n0ki20/kicad_share/3dmodels/RTC_DS3231/HW84_03.png

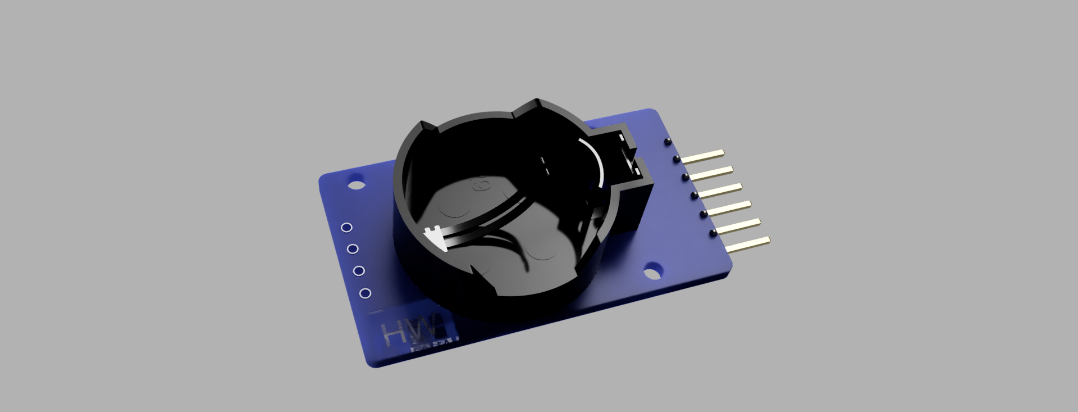
3dmodels/RTC_DS3231/HW84_03.png
