n0ki20/kicad_share/template/KN/Unbe1nannt.png

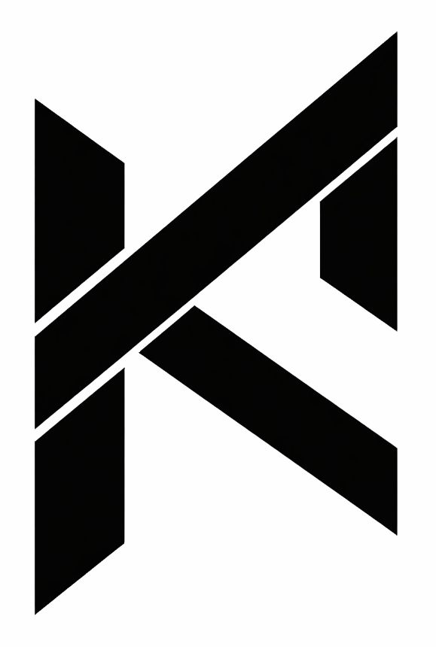
template/KN/Unbe1nannt.png
