n0ki20/kicad_share/3dmodels/ALUTRONIC_FI344SE/Aufsteckkühlkörper, TO-220, 27KW v3.step

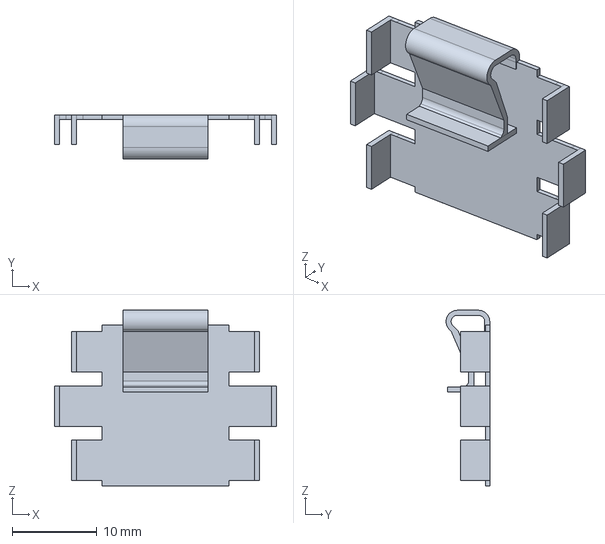
[picture p8: CAD file, 2024-12-22]
3dmodels/ALUTRONIC_FI344SE/Aufsteckkühlkörper, TO-220, 27KW v3.step
26.2 x 5.17 x 20.7 mm
