n0ki20/kicad_share/3dmodels/APEM_ILR3SAD2L0S/ilr3sad2x1242.stp

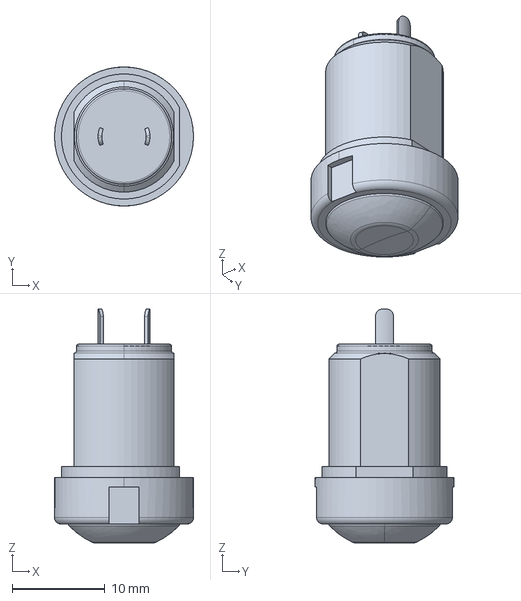
[picture p9: CAD file, 2024-12-22]
3dmodels/APEM_ILR3SAD2L0S/ilr3sad2x1242.stp
15.0 x 15.0 x 25.2 mm
