n0ki20/kicad_share/3dmodels/BOURNS_3296W/Bourns-3296W.step

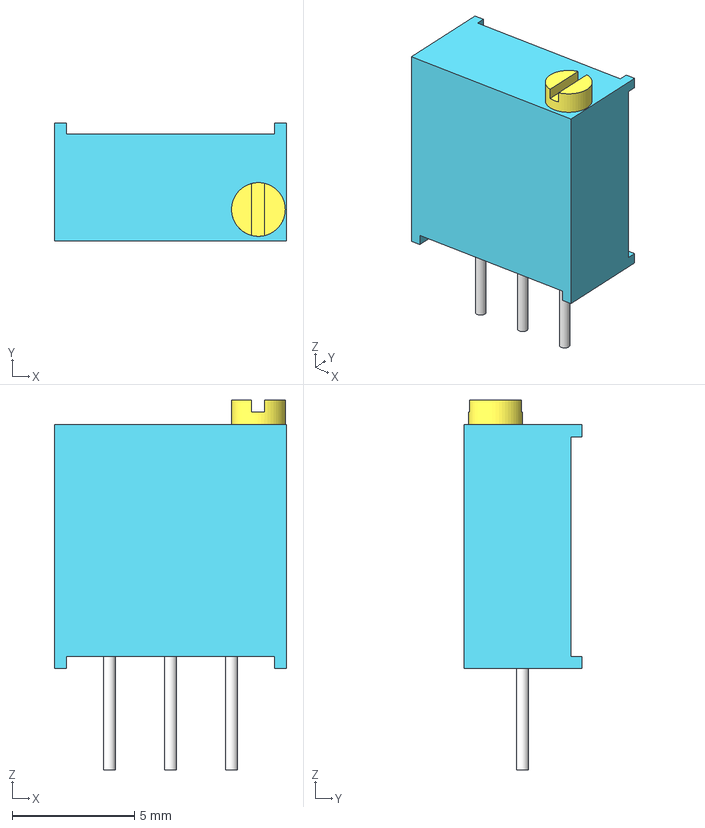
[picture p10: CAD file, 2024-12-22]
3dmodels/BOURNS_3296W/Bourns-3296W.step
9.50 x 4.85 x 15.2 mm
Screw
Pins
