n0ki20/kicad_share/3dmodels/D_SMA.step

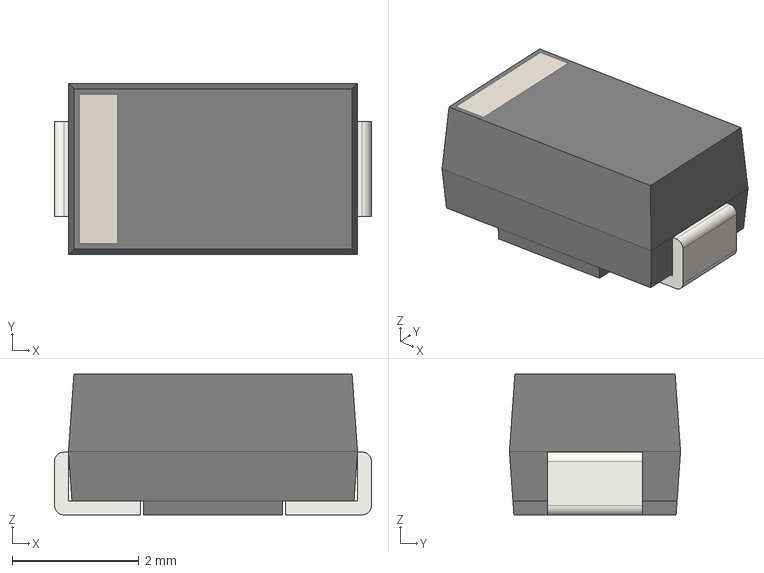
[picture p11: CAD file, 2024-12-22]
3dmodels/D_SMA.step
5.00 x 2.70 x 2.22 mm
