n0ki20/kicad_share/3dmodels/ESP32-WROOM-32E-N4/ESP32-WROOM-32E-N4.stp

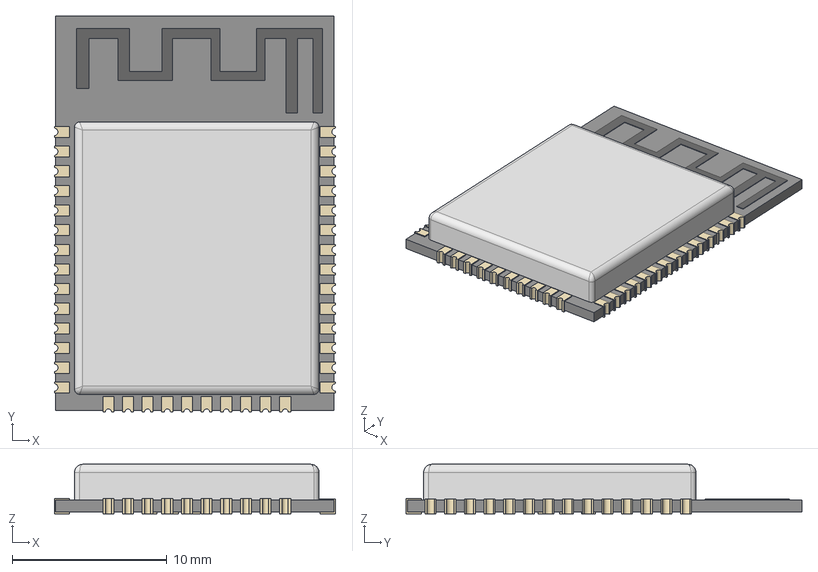
[picture p13: CAD file, 2025-10-26]
3dmodels/ESP32-WROOM-32E-N4/ESP32-WROOM-32E-N4.stp
18.2 x 25.6 x 3.20 mm
