n0ki20/kicad_share/3dmodels/ESP32S3WROOM1N16R8/ESP32-S3-WROOM-1-N16R8.stp

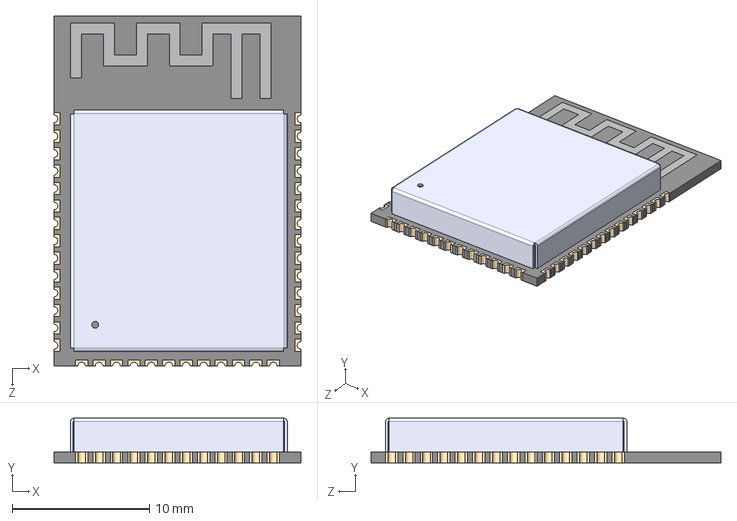
[picture p14: CAD file, 2025-10-26]
3dmodels/ESP32S3WROOM1N16R8/ESP32-S3-WROOM-1-N16R8.stp
18.0 x 3.25 x 25.5 mm
