n0ki20/kicad_share/3dmodels/EVERL_12-23CR6GHBHC-A012C/12-23C_R6GHBHC-A01_2C.stp

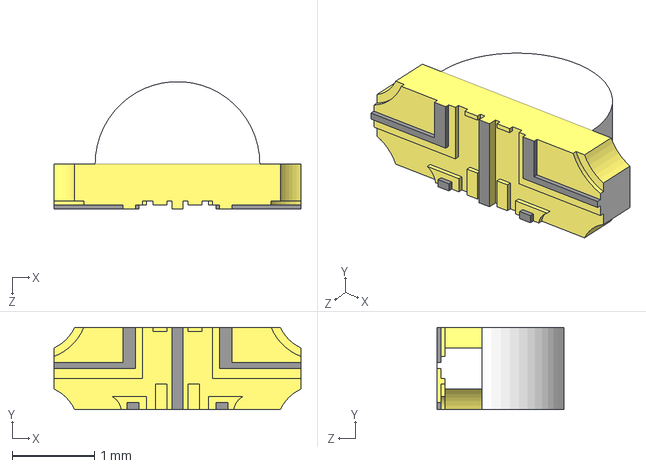
[picture p15: CAD file, 2024-12-22]
3dmodels/EVERL_12-23CR6GHBHC-A012C/12-23C_R6GHBHC-A01_2C.stp
3.00 x 1.00 x 1.55 mm
