n0ki20/kicad_share/3dmodels/FASTR_1008F-220K-08/AISC-1008F-4R7G-T--3DModel-STEP-400430.STEP

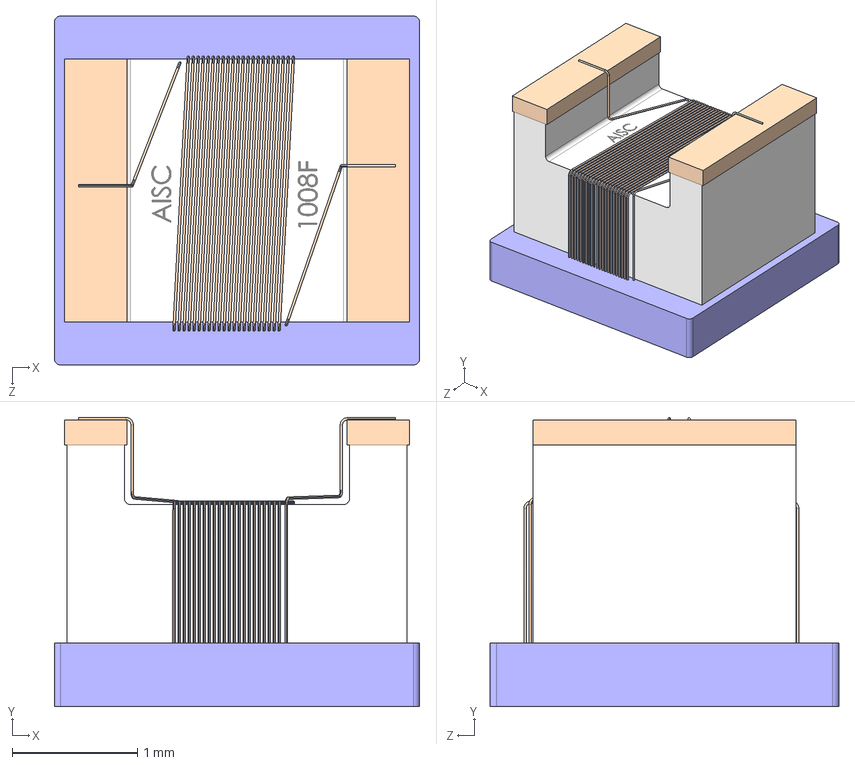
[picture p16: CAD file, 2025-01-09]
3dmodels/FASTR_1008F-220K-08/AISC-1008F-4R7G-T--3DModel-STEP-400430.STEP
2.92 x 2.31 x 2.79 mm
