n0ki20/kicad_share/3dmodels/FASTRON_PISR/PISR-101M-04.stp

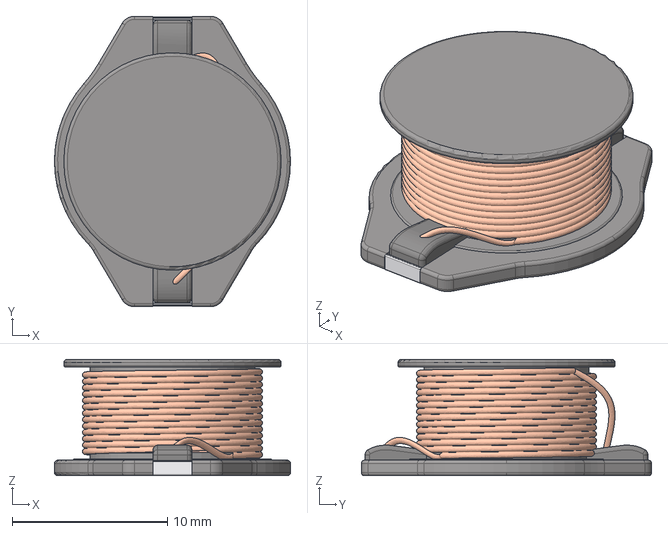
[picture p17: CAD file, 2026-04-06]
3dmodels/FASTRON_PISR/PISR-101M-04.stp
15.2 x 18.7 x 7.50 mm
