n0ki20/kicad_share/3dmodels/FIN_45.31.7.012.0310/4531.stp

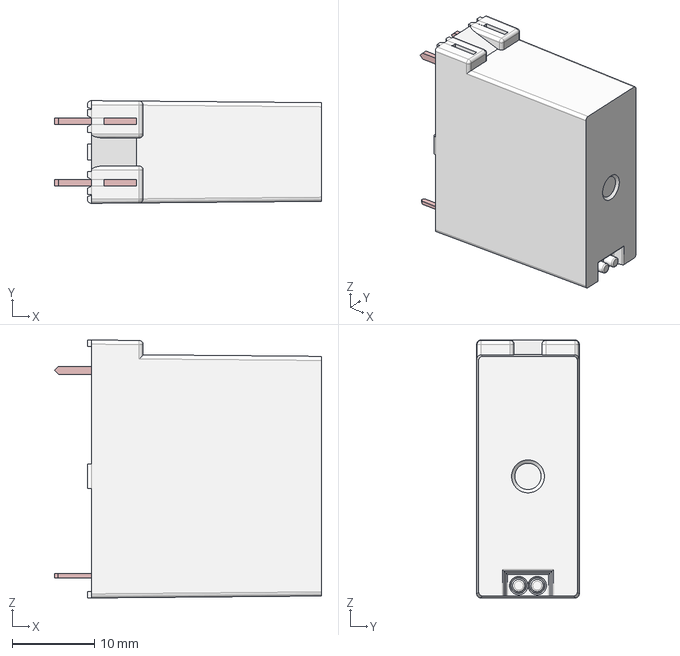
[picture p18: CAD file, 2024-12-22]
3dmodels/FIN_45.31.7.012.0310/4531.stp
32.5 x 12.5 x 31.4 mm
