n0ki20/kicad_share/3dmodels/FISCH_FK 242 SA 220 O/fk_242_sa_220_o.stp

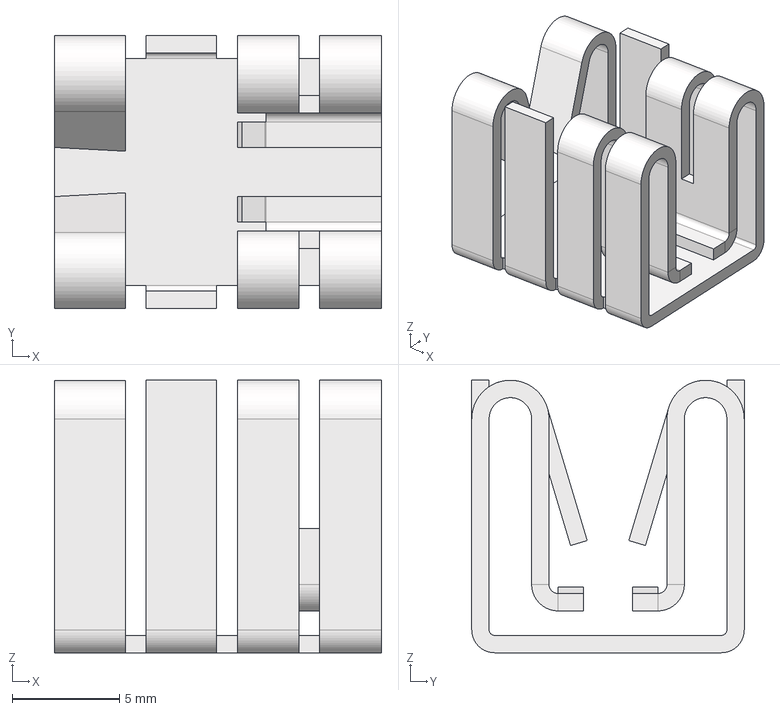
[picture p19: CAD file, 2024-12-22]
3dmodels/FISCH_FK 242 SA 220 O/fk_242_sa_220_o.stp
15.2 x 12.7 x 12.7 mm
