n0ki20/kicad_share/3dmodels/FISCH_FK 244 13 D PAK/fk_244_13_d_pak.stp

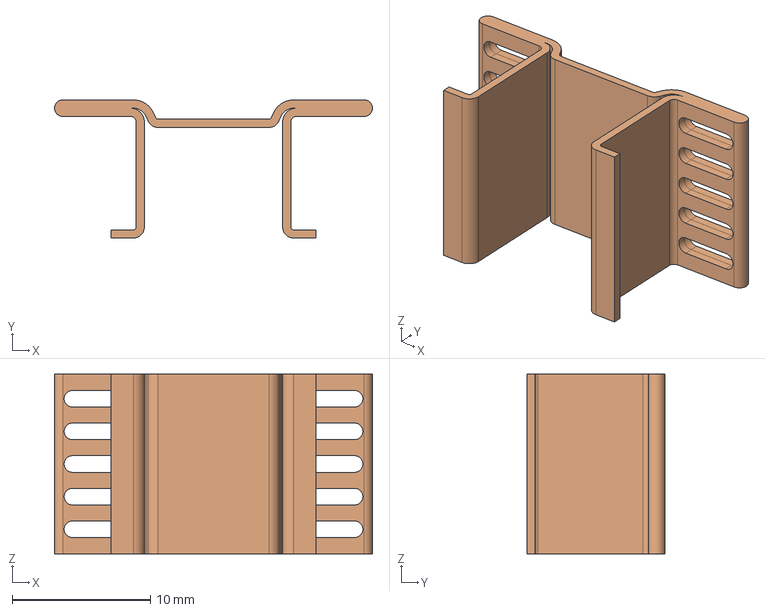
[picture p20: CAD file, 2024-12-22]
3dmodels/FISCH_FK 244 13 D PAK/fk_244_13_d_pak.stp
23.0 x 10.0 x 13.0 mm
