n0ki20/kicad_share/3dmodels/FREESC_MPX2200/User Library-MPX5100GP-2.step

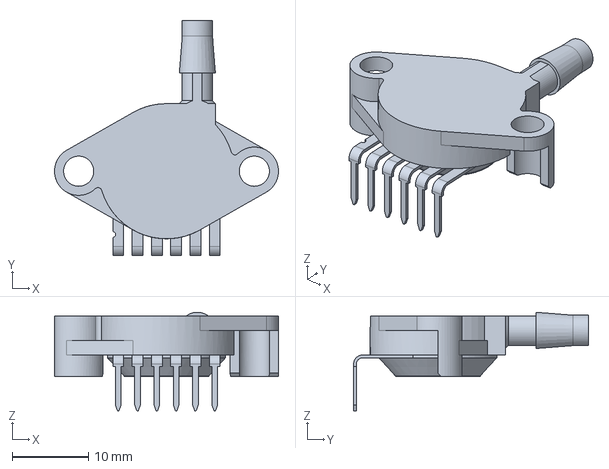
[picture p21: CAD file, 2024-12-22]
3dmodels/FREESC_MPX2200/User Library-MPX5100GP-2.step
29.5 x 30.9 x 13.0 mm
