n0ki20/kicad_share/3dmodels/GCT_BC034-04-A-V-0150-L-D/BC034-04-A-V-0150-L-D--3DModel-STEP-56544.STEP

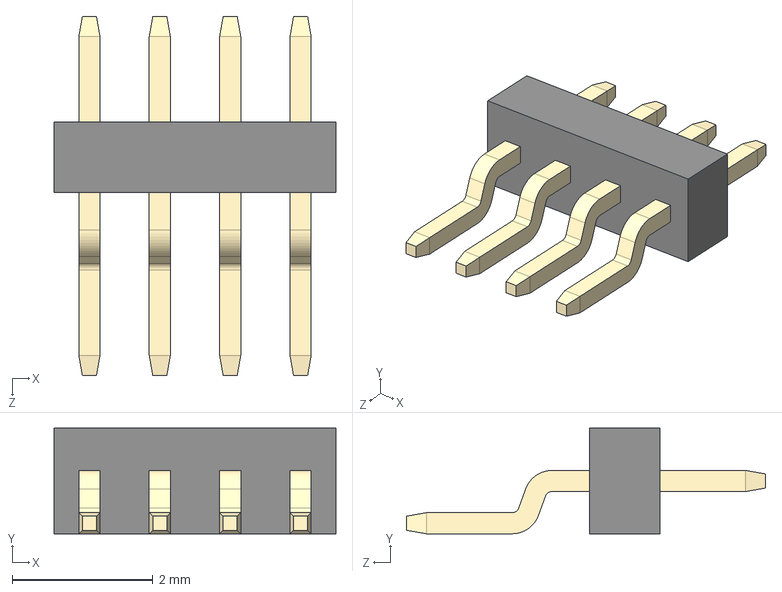
[picture p22: CAD file, 2026-10-28]
3dmodels/GCT_BC034-04-A-V-0150-L-D/BC034-04-A-V-0150-L-D--3DModel-STEP-56544.STEP
4.00 x 1.50 x 5.10 mm
body^BC034-xxxxx
pin^BC034-xxxxx x 4
