n0ki20/kicad_share/3dmodels/GENICOM_GUVA-S12SD/CR_GUVA-S12SD_GCM.step

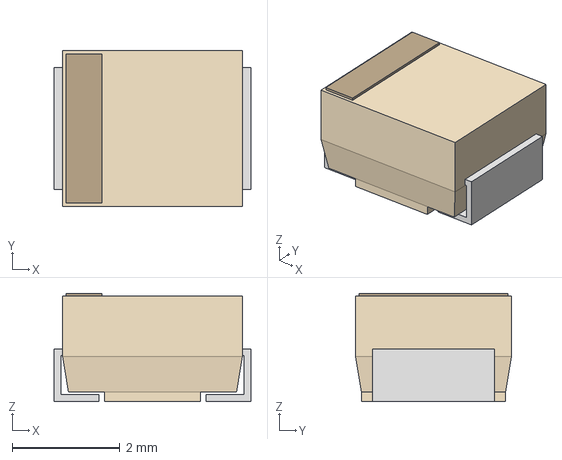
[picture p23: CAD file, 2026-08-25]
3dmodels/GENICOM_GUVA-S12SD/CR_GUVA-S12SD_GCM.step
3.66 x 2.90 x 2.01 mm
