n0ki20/kicad_share/3dmodels/I2C-OLED-Display_128x32/128x32-OLED.STEP

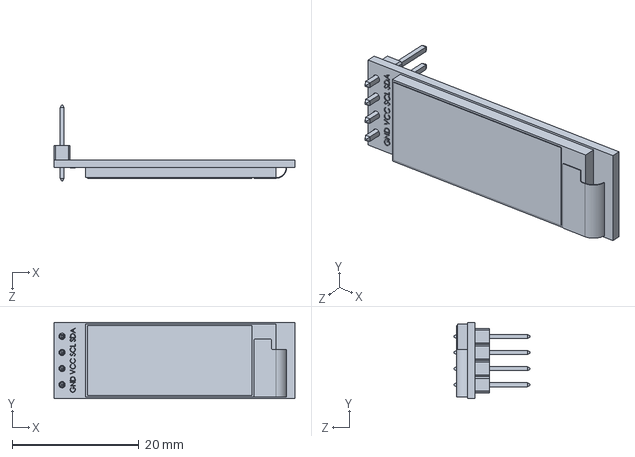
[picture p24: CAD file, 2024-12-22]
3dmodels/I2C-OLED-Display_128x32/128x32-OLED.STEP
38.0 x 12.0 x 11.9 mm
