n0ki20/kicad_share/3dmodels/I2C-OLED-Display_128x64/0,96-Zoll_OLED_IIC.stp

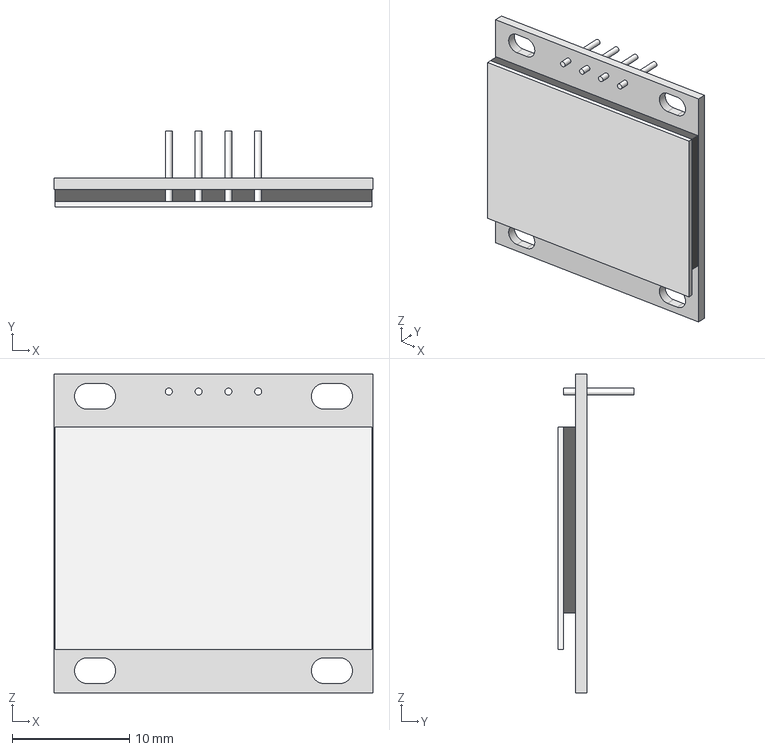
[picture p25: CAD file, 2024-12-22]
3dmodels/I2C-OLED-Display_128x64/0,96-Zoll_OLED_IIC.stp
27.2 x 6.50 x 27.2 mm
