n0ki20/kicad_share/3dmodels/I2C-OLED-Display_128x64_1.3/HiLetgo - DM-OLED13-625.stp

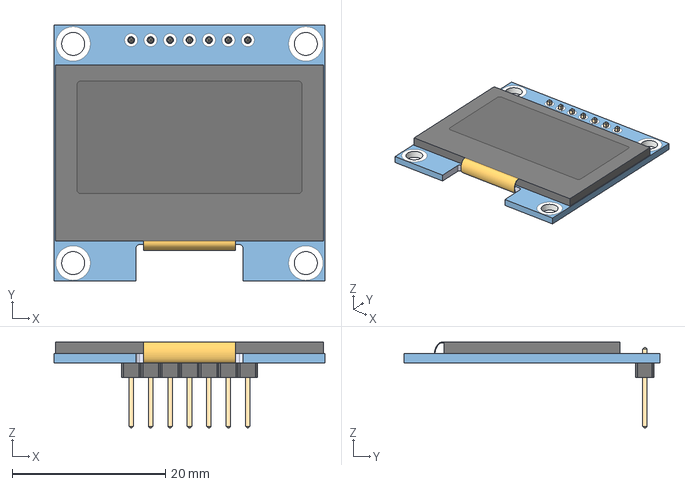
[picture p26: CAD file, 2024-12-22]
3dmodels/I2C-OLED-Display_128x64_1.3/HiLetgo - DM-OLED13-625.stp
35.4 x 33.5 x 11.2 mm
