n0ki20/kicad_share/3dmodels/JOY_ESP-12F/esp-12f.stp

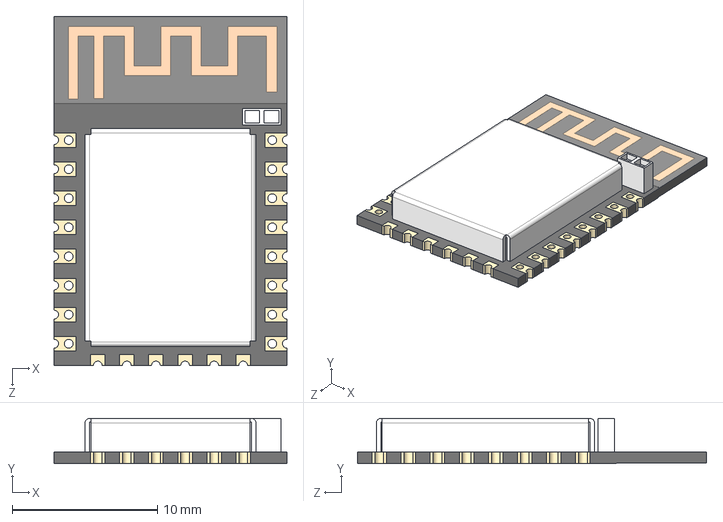
[picture p27: CAD file, 2024-12-22]
3dmodels/JOY_ESP-12F/esp-12f.stp
16.0 x 3.10 x 24.0 mm
