n0ki20/kicad_share/3dmodels/JST_B2P-SHF-1AA(LF)(SN)/JST_-_B2P-SHF-1AA-LFSN.step

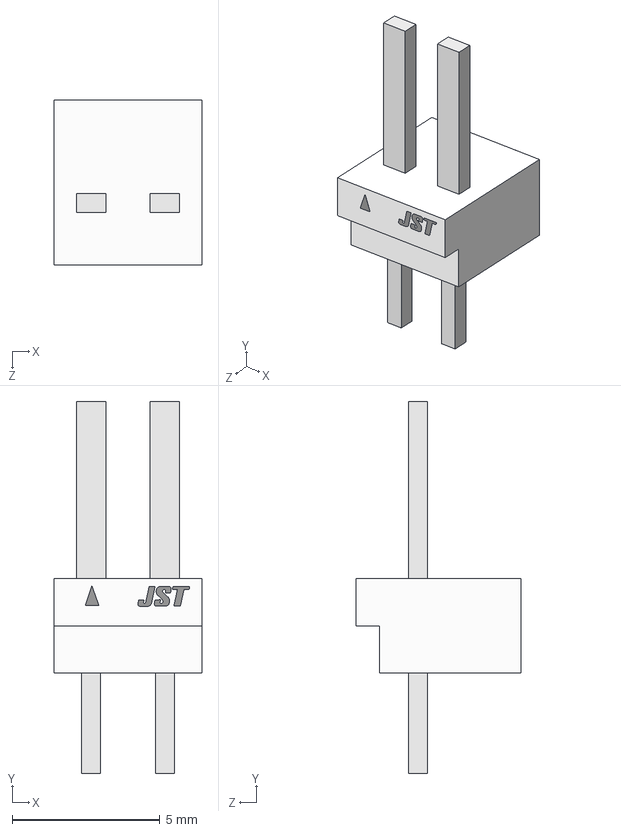
[picture p28: CAD file, 2024-12-22]
3dmodels/JST_B2P-SHF-1AA(LF)(SN)/JST_-_B2P-SHF-1AA-LFSN.step
5.00 x 12.6 x 5.60 mm
Pins
New Marking
JST Logo
