n0ki20/kicad_share/3dmodels/KEY_1012/BatteryHolder_Keystone_1012_2xAA.step

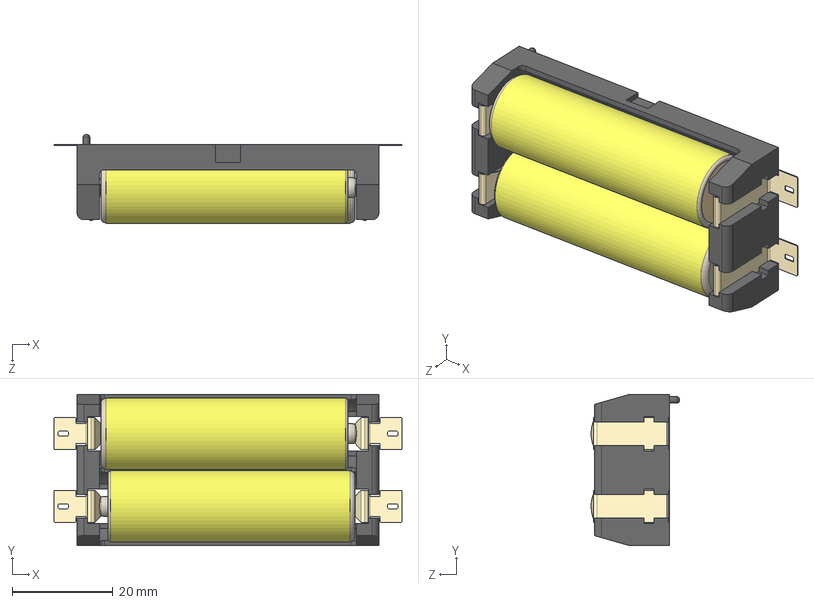
[picture p29: CAD file, 2024-12-22]
3dmodels/KEY_1012/BatteryHolder_Keystone_1012_2xAA.step
69.0 x 30.0 x 17.6 mm
AAx2 SMT 422 Battery Holder
connector x 4
AA Battery_new x 2
bung_battery x 2
grafite_electrode x 2
cap x 2
