n0ki20/kicad_share/3dmodels/KEY_1013/keystone-PN1013.STEP

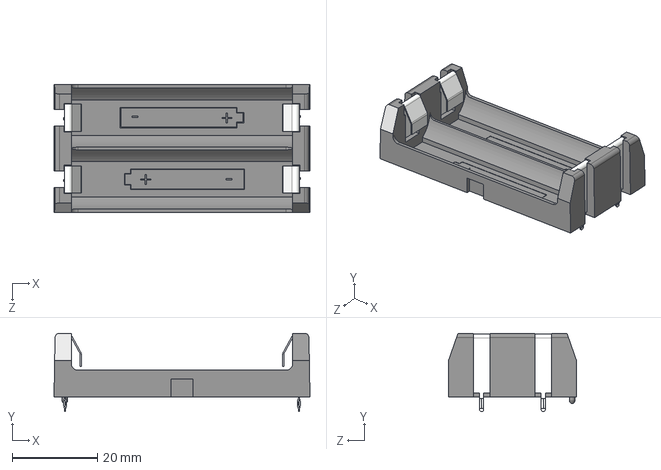
[picture p30: CAD file, 2024-12-22]
3dmodels/KEY_1013/keystone-PN1013.STEP
59.9 x 18.3 x 30.0 mm
