n0ki20/kicad_share/3dmodels/KEY_1022/1022.step

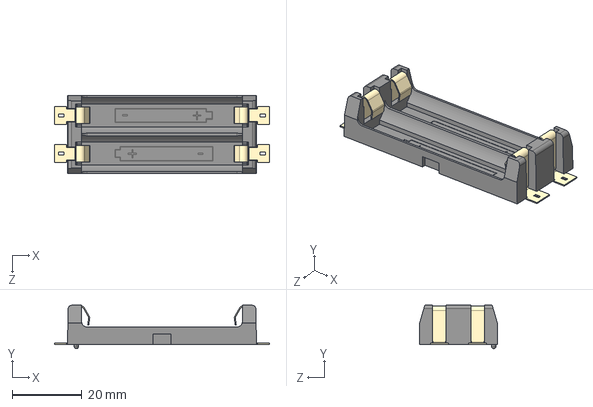
[picture p31: CAD file, 2024-12-22]
3dmodels/KEY_1022/1022.step
61.5 x 12.4 x 22.2 mm
