n0ki20/kicad_share/3dmodels/KEY_1023/1023.step

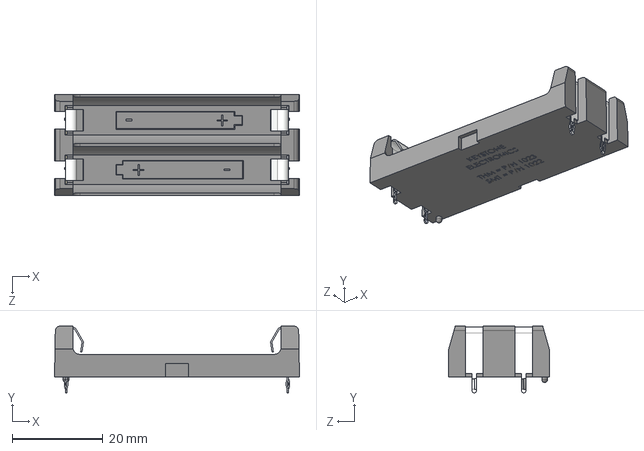
[picture p32: CAD file, 2025-04-23]
3dmodels/KEY_1023/1023.step
54.1 x 14.7 x 22.2 mm
