n0ki20/kicad_share/3dmodels/KEY_KEYS7693/7693--3DModel-STEP-630548.STEP

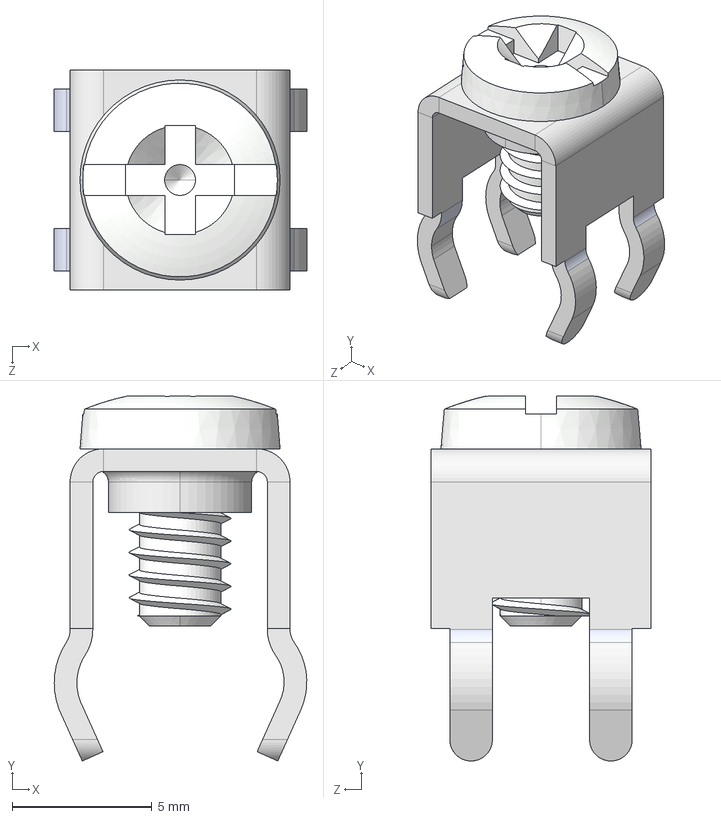
[picture p33: CAD file, 2024-12-22]
3dmodels/KEY_KEYS7693/7693--3DModel-STEP-630548.STEP
9.04 x 13.1 x 7.87 mm
