n0ki20/kicad_share/3dmodels/LTPL-G35UV275GR-E/LTPL-G35UV275GR-E.stp

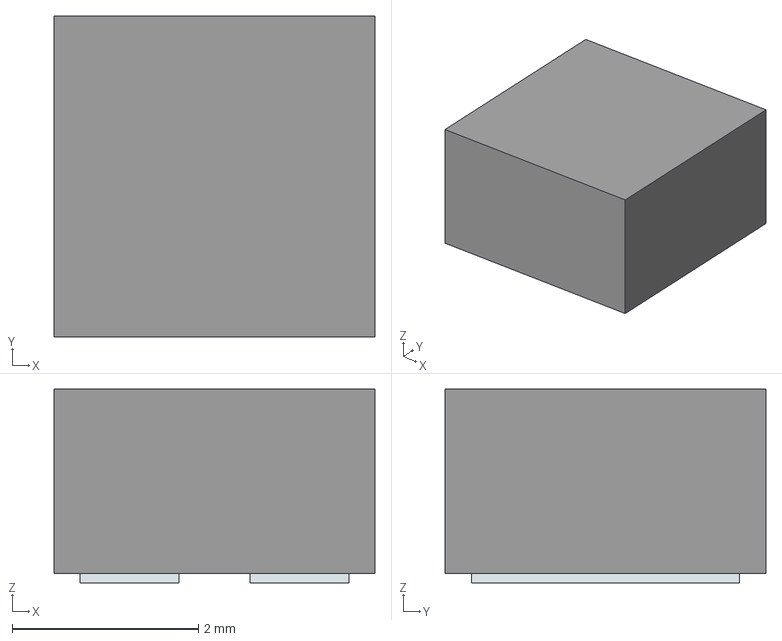
[picture p34: CAD file, 2026-04-06]
3dmodels/LTPL-G35UV275GR-E/LTPL-G35UV275GR-E.stp
3.45 x 3.45 x 2.08 mm
Pins
