n0ki20/kicad_share/3dmodels/LUCKY_C3535DUVCQBQ5D/LUCKY_C3535DUVCQBQ5D.stp

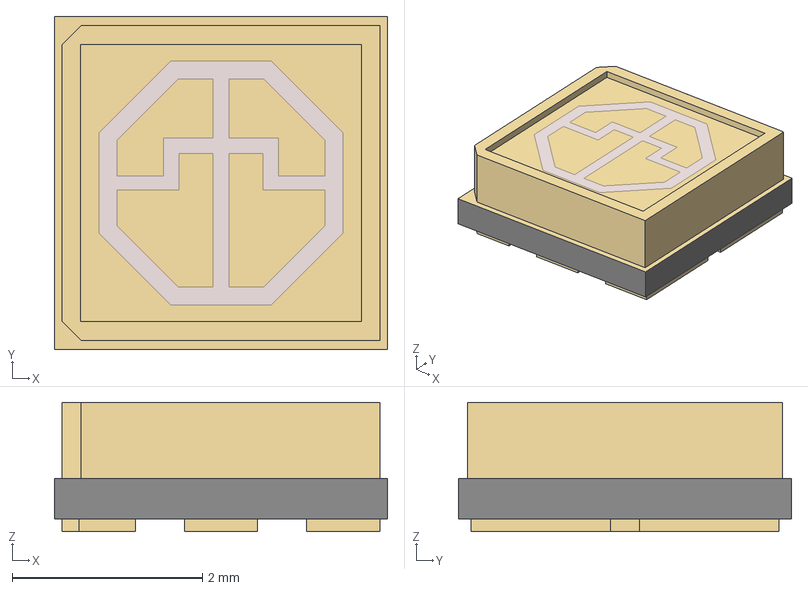
[picture p35: CAD file, 2026-10-28]
3dmodels/LUCKY_C3535DUVCQBQ5D/LUCKY_C3535DUVCQBQ5D.stp
3.50 x 3.50 x 1.36 mm
