n0ki20/kicad_share/3dmodels/METZ_SR99S01VBNN01/SR99.stp

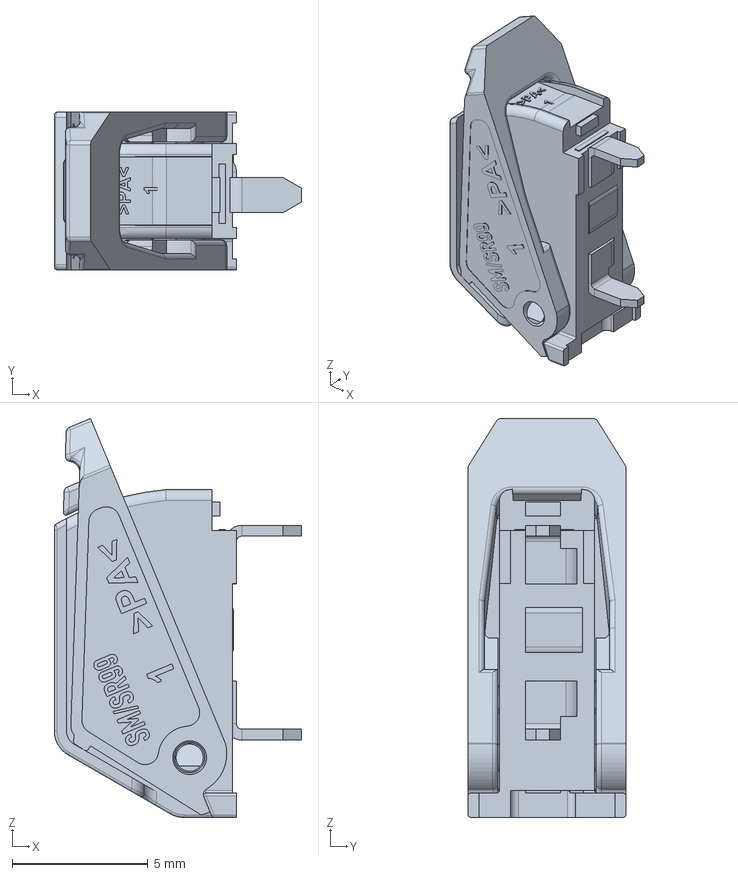
[picture p36: CAD file, 2024-12-22]
3dmodels/METZ_SR99S01VBNN01/SR99.stp
9.10 x 5.80 x 14.7 mm
