n0ki20/kicad_share/3dmodels/OSRAM_AS7331-AQF/AS7331-AQFT.stp

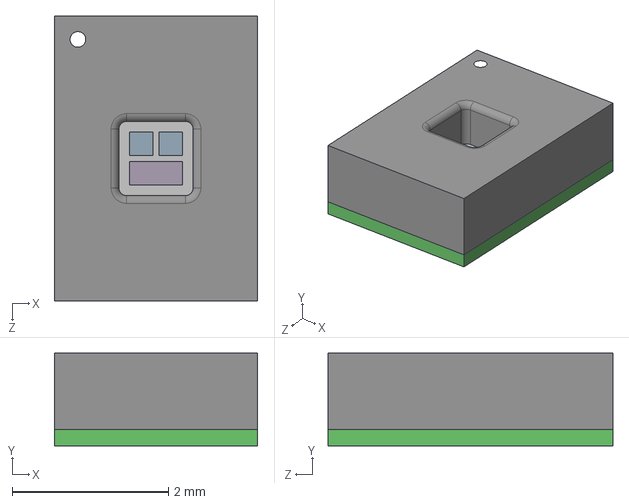
[picture p37: CAD file, 2026-08-25]
3dmodels/OSRAM_AS7331-AQF/AS7331-AQFT.stp
2.60 x 1.19 x 3.65 mm
