n0ki20/kicad_share/3dmodels/R_0508/R_0508.stp

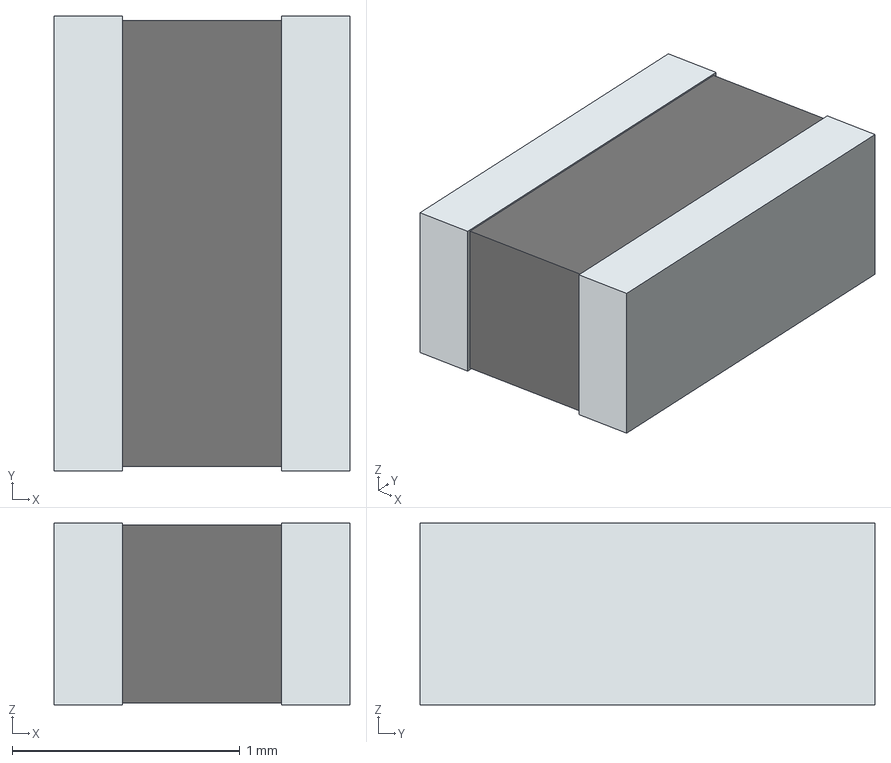
[picture p38: CAD file, 2026-10-28]
3dmodels/R_0508/R_0508.stp
1.30 x 2.00 x 0.8 mm
term1
term2
