n0ki20/kicad_share/3dmodels/RTC_DS1307_DS1302/REAL_TIME_SHEELD.stp

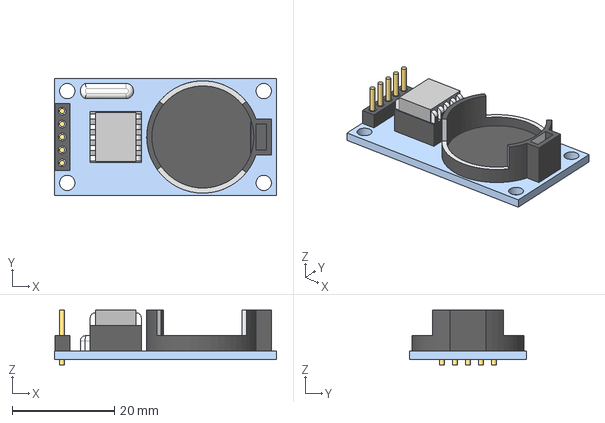
[picture p39: CAD file, 2024-12-22]
3dmodels/RTC_DS1307_DS1302/REAL_TIME_SHEELD.stp
43.5 x 23.0 x 10.7 mm
