n0ki20/kicad_share/3dmodels/RTC_DS3231/HW-84 v7.step

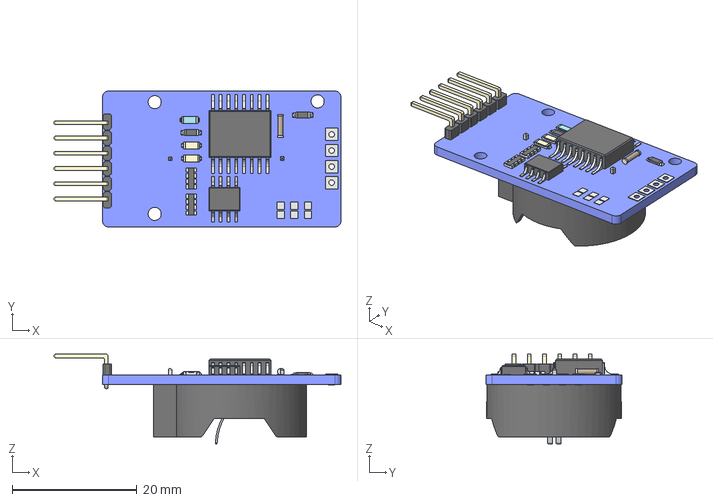
[picture p40: CAD file, 2024-12-22]
3dmodels/RTC_DS3231/HW-84 v7.step
46.1 x 21.9 x 14.4 mm
