n0ki20/kicad_share/3dmodels/SW_ALPS_402097/EC11-THT-25K-black.step

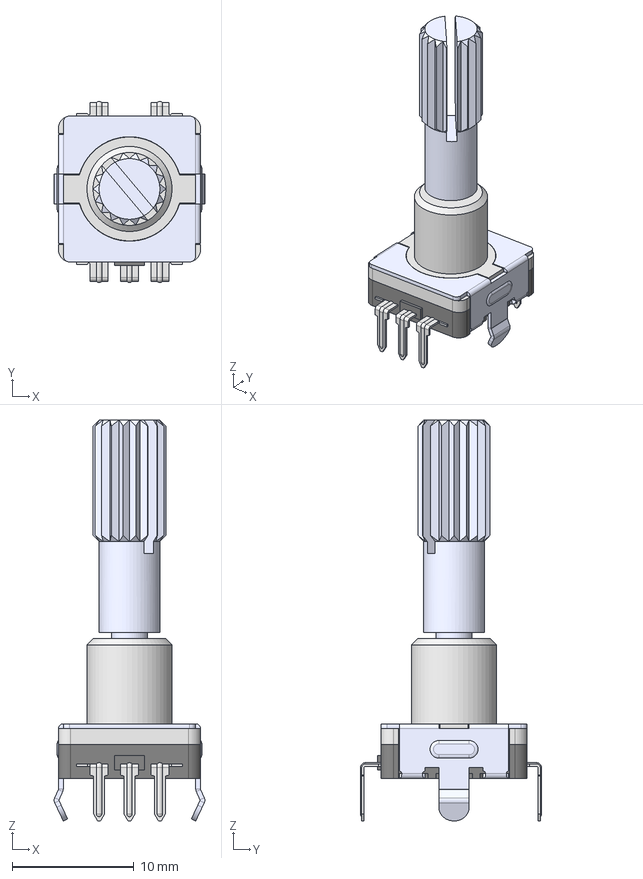
[picture p41: CAD file, 2024-12-22]
3dmodels/SW_ALPS_402097/EC11-THT-25K-black.step
12.4 x 14.9 x 33.0 mm
Lb7
25K
EC11-Housing-THT
