n0ki20/kicad_share/3dmodels/TRACO_TSR 0.5SM/TSR_0.5-2450SM.stp

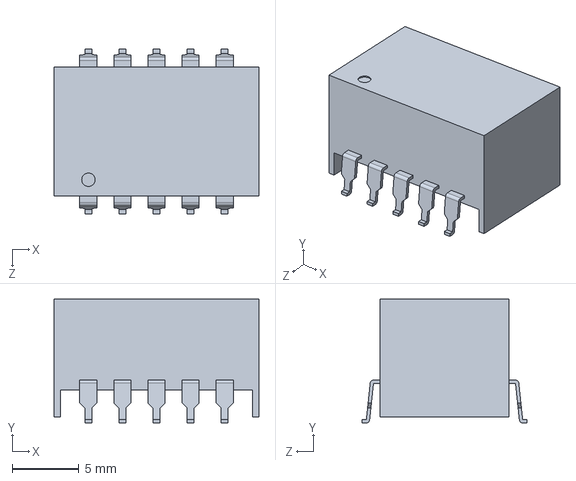
[picture p42: CAD file, 2024-12-22]
3dmodels/TRACO_TSR 0.5SM/TSR_0.5-2450SM.stp
15.3 x 9.24 x 12.4 mm
