n0ki20/kicad_share/3dmodels/VIS_VLMU35CR40-275-120/VIS_VLMU35CR40-275-120.stp

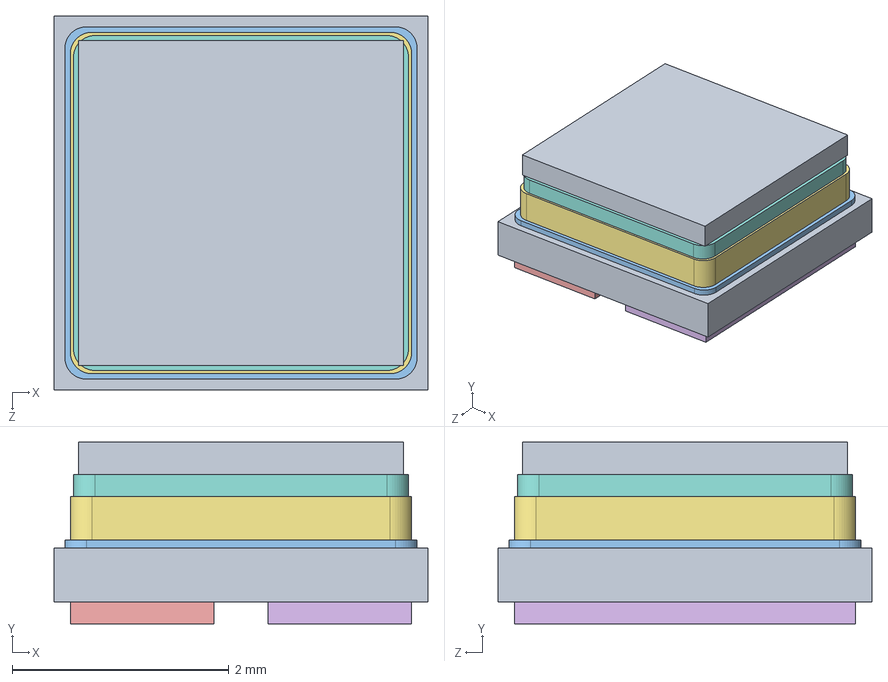
[picture p43: CAD file, 2026-10-28]
3dmodels/VIS_VLMU35CR40-275-120/VIS_VLMU35CR40-275-120.stp
3.45 x 1.68 x 3.45 mm
G35UVC280SL SUB
G35UVC280SL CHIP PAD
G35UVC280SL SOLDER PAD
G35UVC280SL CAVITY
G35UVC280SL DAM
G35UVC280SL GLASS
G35UVCGP_chip
