n0ki20/kicad_share/3dmodels/WAGO_2059-303998-403/WAGO_2059-303998-403.stp

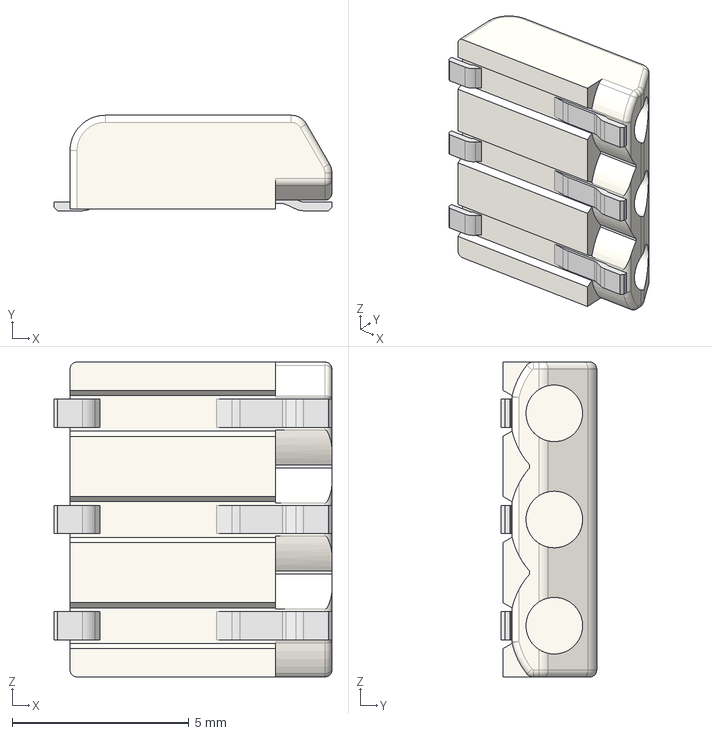
[picture p44: CAD file, 2026-04-29]
3dmodels/WAGO_2059-303998-403/WAGO_2059-303998-403.stp
7.85 x 2.70 x 8.90 mm
