n0ki20/kicad_share/3dmodels/WAGO_233-502/233-502.stp

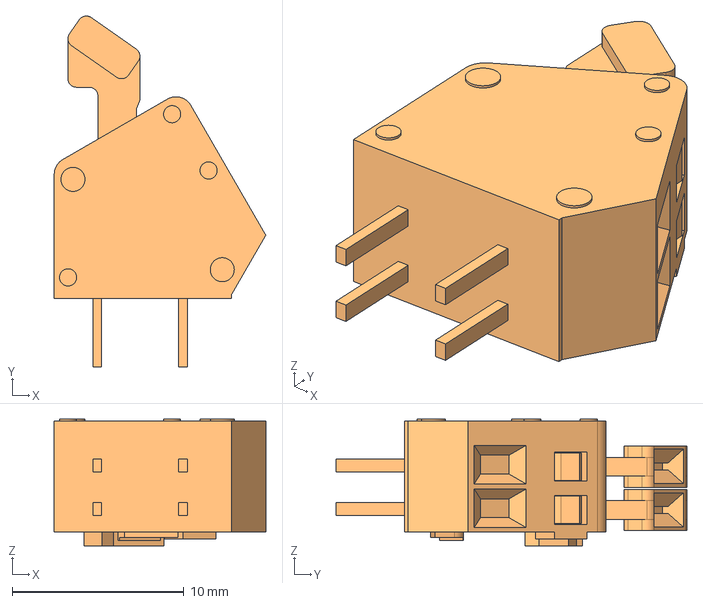
[picture p45: CAD file, 2024-12-22]
3dmodels/WAGO_233-502/233-502.stp
12.3 x 20.4 x 7.38 mm
