n0ki20/kicad_share/3dmodels/WAGO_233-503/233-503.stp

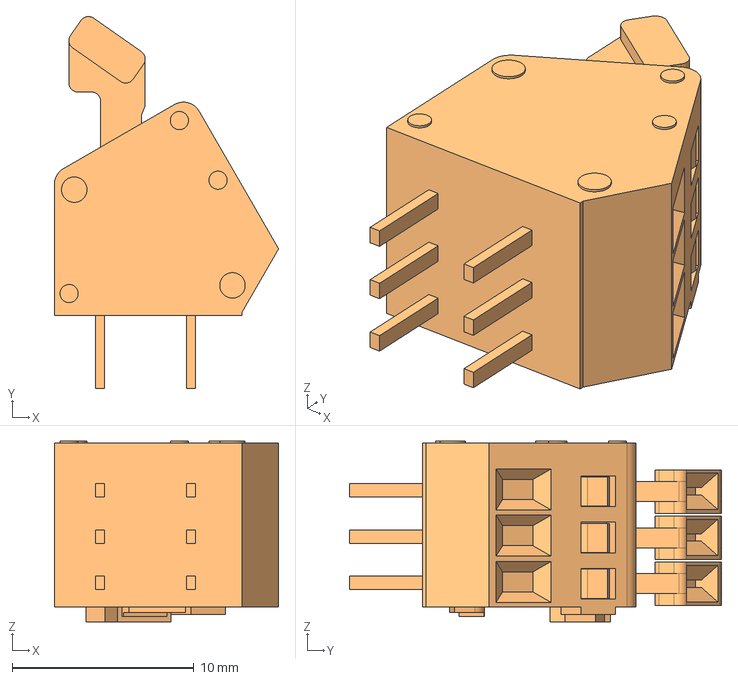
[picture p46: CAD file, 2024-12-22]
3dmodels/WAGO_233-503/233-503.stp
12.3 x 20.4 x 9.92 mm
