n0ki20/kicad_share/3dmodels/WAGO_233-504/233-504.stp

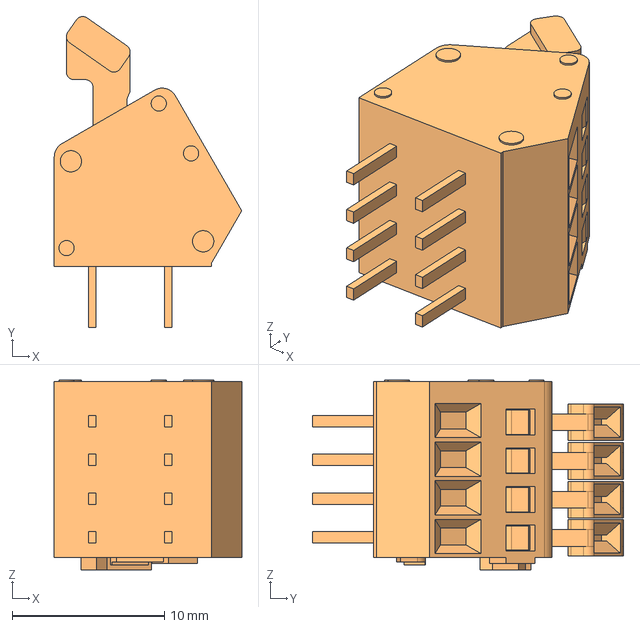
[picture p47: CAD file, 2024-12-22]
3dmodels/WAGO_233-504/233-504.stp
12.3 x 20.4 x 12.5 mm
