n0ki20/kicad_share/3dmodels/WAGO_233-505/233-505.stp

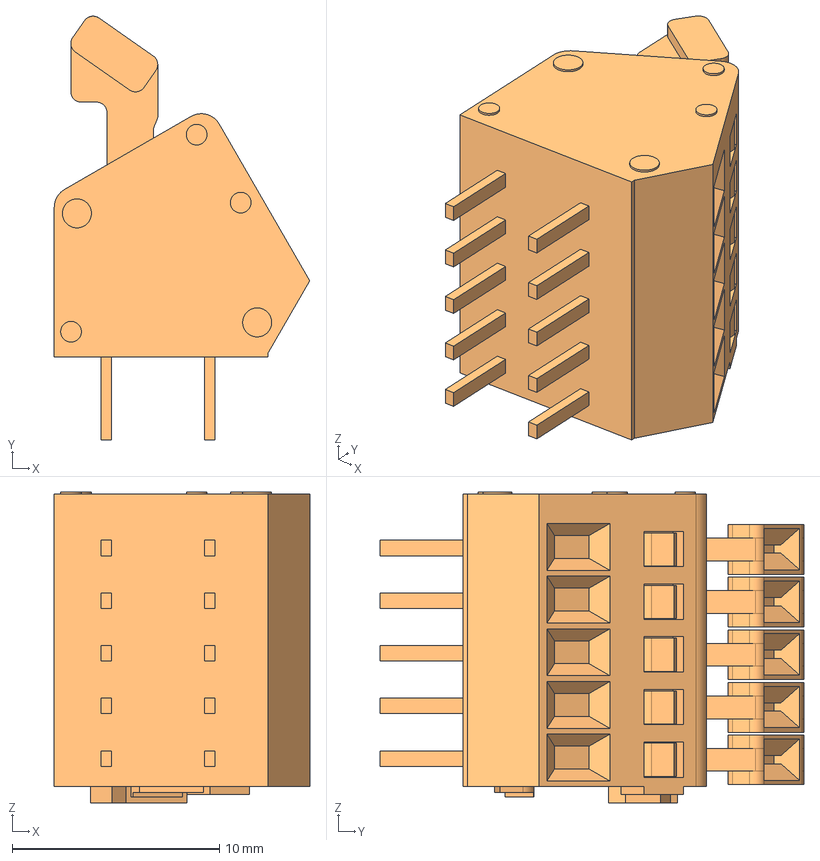
[picture p48: CAD file, 2024-12-22]
3dmodels/WAGO_233-505/233-505.stp
12.3 x 20.4 x 15.0 mm
