n0ki20/kicad_share/3dmodels/WAGO_2604-1102/2604-1102.stp

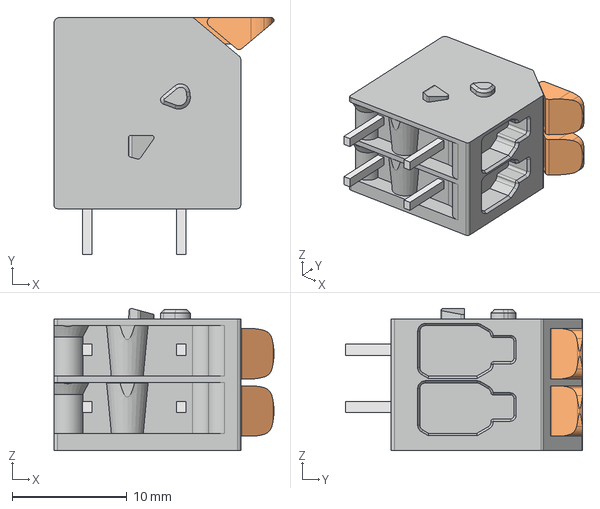
[picture p49: CAD file, 2024-12-22]
3dmodels/WAGO_2604-1102/2604-1102.stp
19.2 x 20.7 x 12.4 mm
