n0ki20/kicad_share/3dmodels/WAGO_2604-1106/M_2604-1106_WAGO.stp

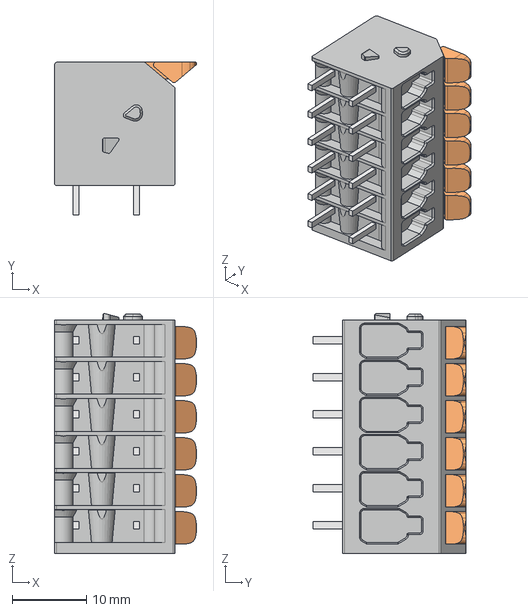
[picture p50: CAD file, 2024-12-22]
3dmodels/WAGO_2604-1106/M_2604-1106_WAGO.stp
19.2 x 20.7 x 32.4 mm
