n0ki20/kicad_share/3dmodels/WE_150066SV74000/WE_150066SV74000.stp

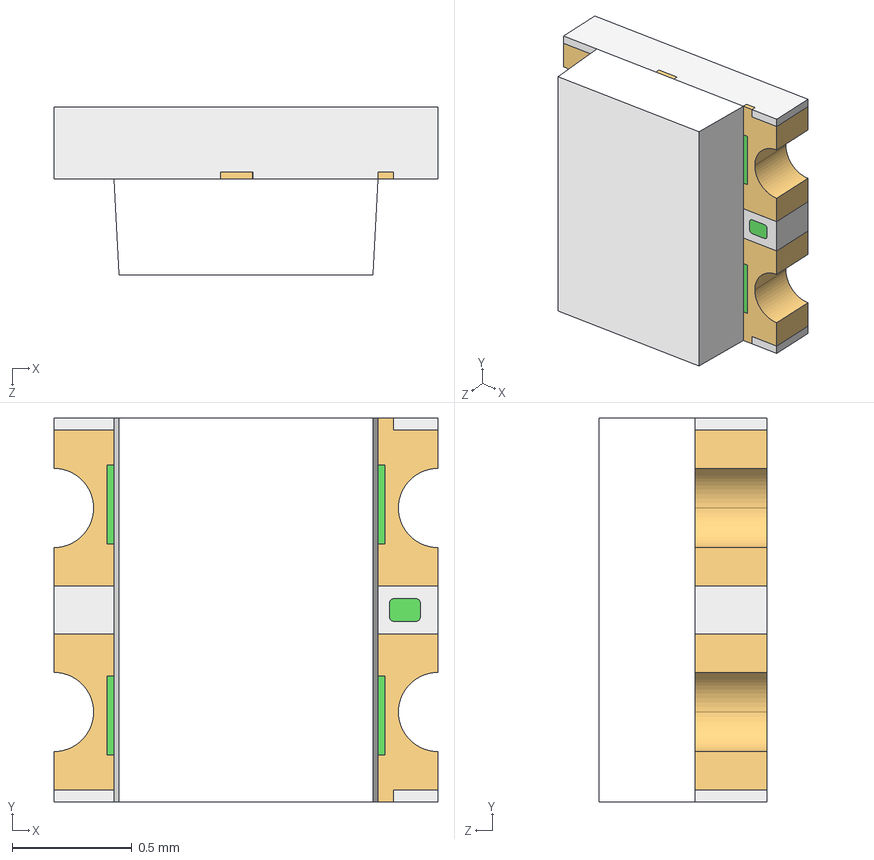
[picture p51: CAD file, 2025-01-17]
3dmodels/WE_150066SV74000/WE_150066SV74000.stp
1.60 x 1.60 x 0.7 mm
pole
contact
lense
