n0ki20/kicad_share/3dmodels/X/PinHeader_1x15_2.54_90_THT.step

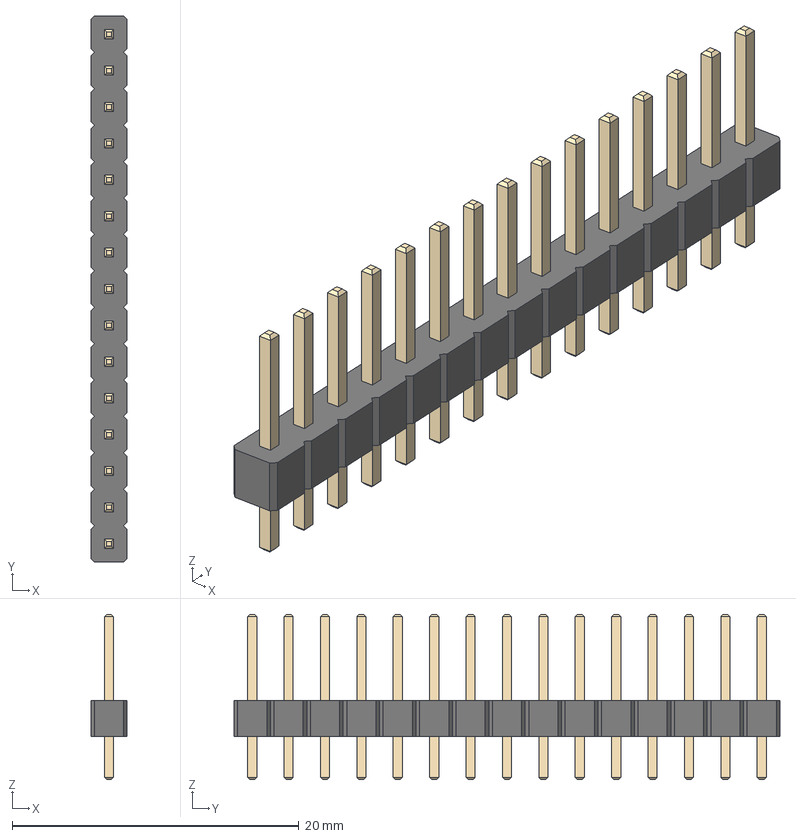
[picture p52: CAD file, 2025-10-26]
3dmodels/X/PinHeader_1x15_2.54_90_THT.step
2.54 x 38.1 x 11.5 mm
