n0ki20/kicad_share/3dmodels/ZETT_AZ9371-1A-12DE/Zettler_AZ9371-1A-12DE v2.step

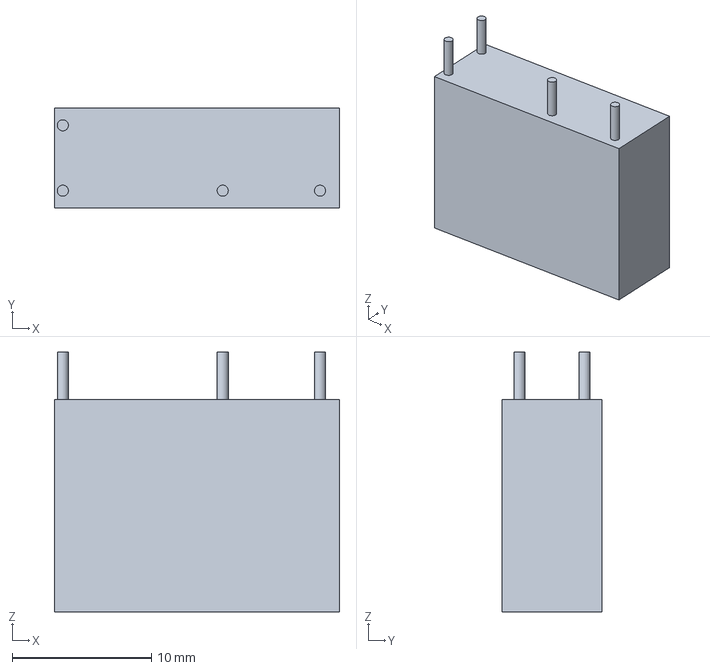
[picture p53: CAD file, 2024-12-22]
3dmodels/ZETT_AZ9371-1A-12DE/Zettler_AZ9371-1A-12DE v2.step
20.5 x 7.20 x 18.7 mm
