n0ki20/kicad_share/3dmodels/D_SOD-523.step

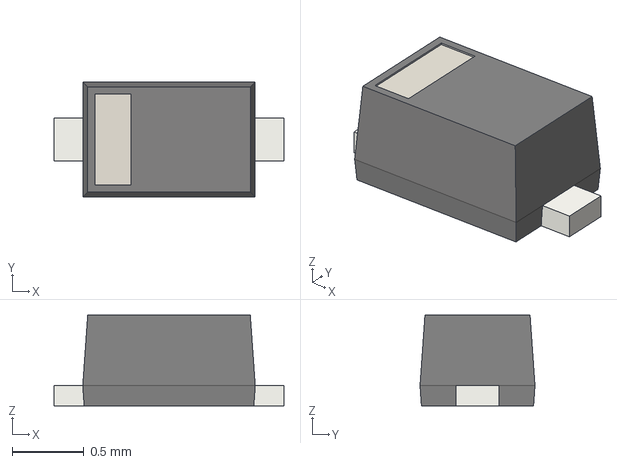
[picture p54: CAD file, 2024-12-22]
3dmodels/D_SOD-523.step
1.60 x 0.8 x 0.63 mm
