n0ki20/kicad_share/3dmodels/DEGSON_DG308 Series/DG308-2.54-07P-14-00AH.STEP

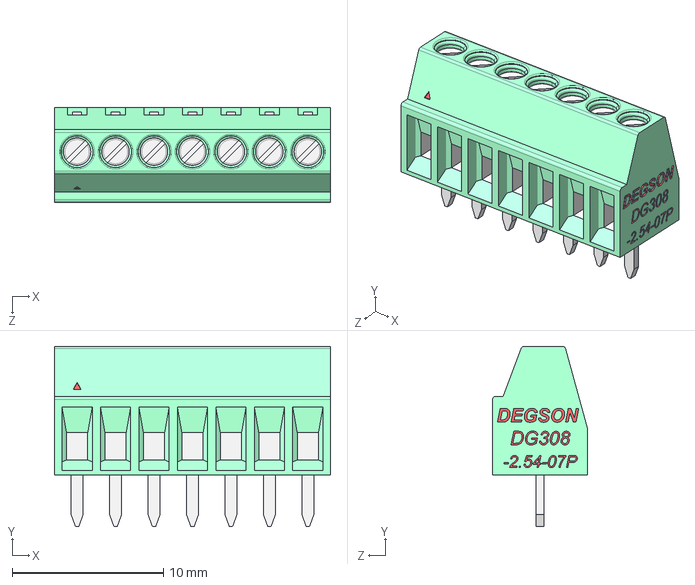
[picture p60: CAD file, 2024-12-22]
3dmodels/DEGSON_DG308 Series/DG308-2.54-07P-14-00AH.STEP
18.2 x 11.9 x 6.27 mm
