n0ki20/kicad_share/3dmodels/SW_ALPS_402097/EC11-THT-15K-green.step

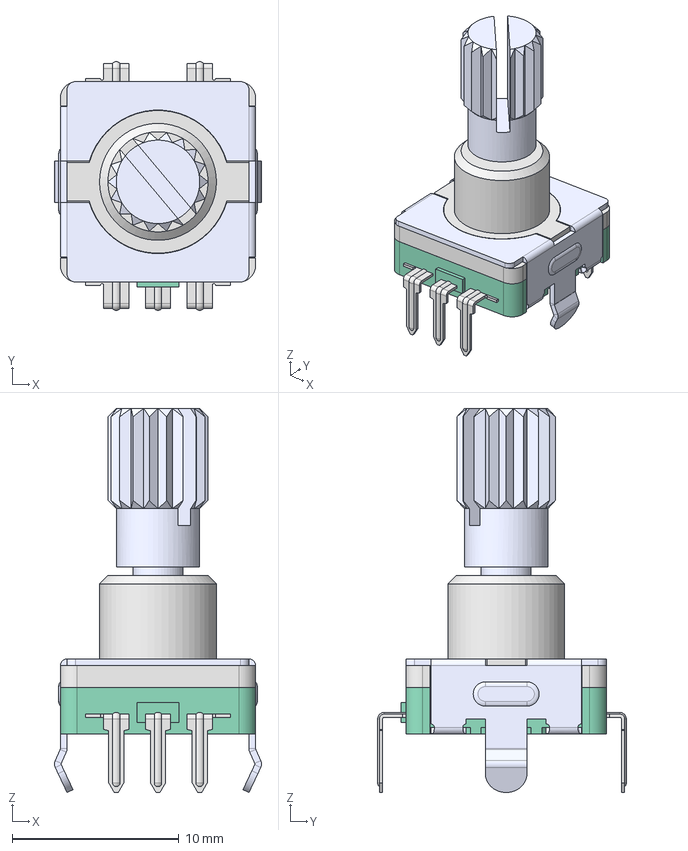
[picture p61: CAD file, 2024-12-22]
3dmodels/SW_ALPS_402097/EC11-THT-15K-green.step
12.4 x 14.9 x 23.0 mm
Lb5
15K
EC11-Housing-THT
