n0ki20/kicad_share/3dmodels/SW_ALPS_402097/EC11-THT-25F-thread-blue.step

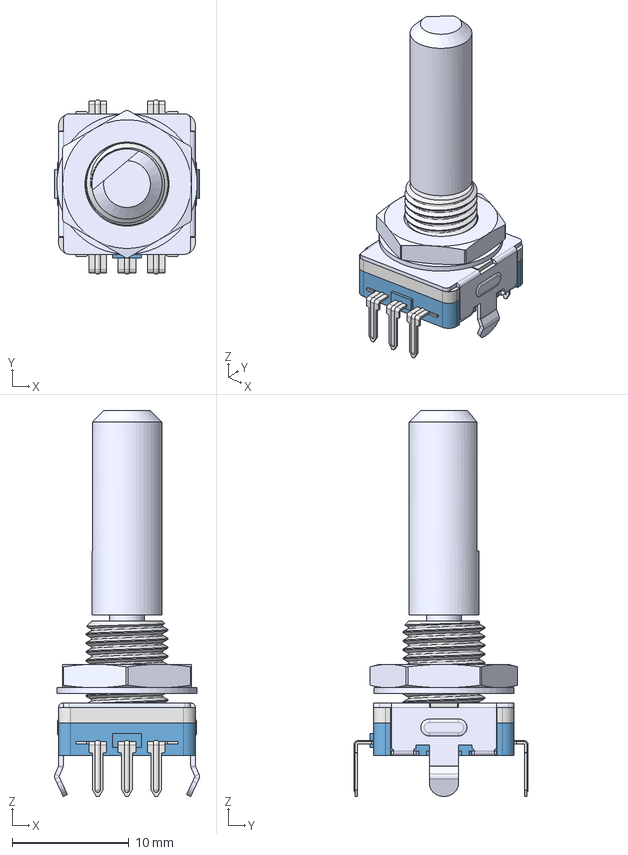
[picture p71: CAD file, 2024-12-22]
3dmodels/SW_ALPS_402097/EC11-THT-25F-thread-blue.step
12.4 x 14.9 x 33.0 mm
Lb7 TH
25F
EC11-Housing-THT
