n0ki20/kicad_share/3dmodels/SW_ALPS_402097/EC11-THT-20R-blue.step

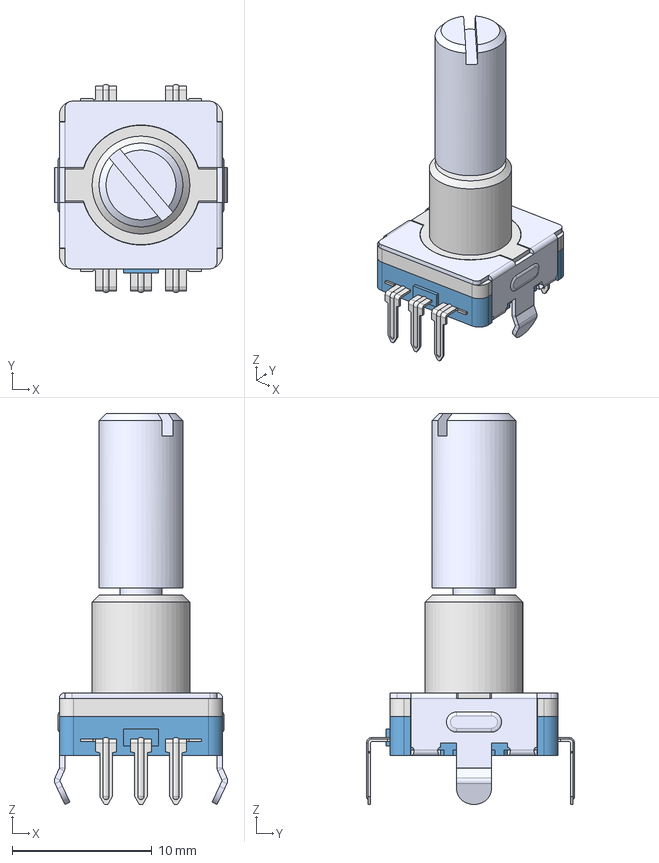
[picture p72: CAD file, 2024-12-22]
3dmodels/SW_ALPS_402097/EC11-THT-20R-blue.step
12.4 x 14.9 x 28.0 mm
Lb7
20R
EC11-Housing-THT
