n0ki20/kicad_share/3dmodels/SW_ALPS_402097/EC11-THT-25R-thread-black.step

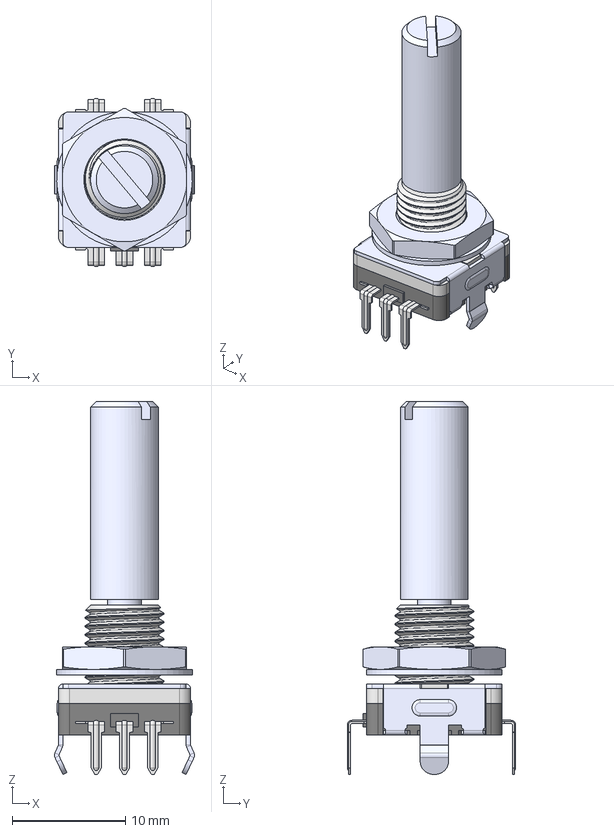
[picture p74: CAD file, 2024-12-22]
3dmodels/SW_ALPS_402097/EC11-THT-25R-thread-black.step
12.4 x 14.9 x 33.0 mm
Lb7 TH
25R
EC11-Housing-THT
