n0ki20/kicad_share/(list of files, cad)

Other CAD files:
3dmodels/SW_ALPS_402097/EC11-THT-25K-thread-green.step
3dmodels/SW_ALPS_402097/EC11-THT-15K-thread-green.step
3dmodels/SW_ALPS_402097/EC11-THT-15K-blue.step
3dmodels/SW_ALPS_402097/EC11-THT-20R-green.step
3dmodels/SW_ALPS_402097/EC11-THT-15F-thread-green.step
3dmodels/SW_ALPS_402097/EC11-THT-15K-thread-blue.step
3dmodels/SW_ALPS_402097/EC11-THT-20K-green.step
3dmodels/SW_ALPS_402097/EC11-THT-25F-thread-black.step
3dmodels/SW_ALPS_402097/EC11-THT-20K-blue.step
3dmodels/SW_ALPS_402097/EC11-THT-15K-black.step
3dmodels/SW_ALPS_402097/EC11-THT-25K-blue.step
3dmodels/SW_ALPS_402097/EC11-THT-20R-thread-green.step
3dmodels/SW_ALPS_402097/EC11-THT-25R-blue.step
3dmodels/SW_ALPS_402097/1 EC11-THT-15F-black.stp
3dmodels/SW_ALPS_402097/EC11-THT-20R-thread-black.step
3dmodels/SW_ALPS_402097/EC11-THT-15F-thread-black.step
3dmodels/SW_ALPS_402097/EC11-THT-15F-green.step
3dmodels/SW_ALPS_402097/EC11-THT-15F-blue.step
3dmodels/SW_ALPS_402097/EC11-THT-20F-black.step
3dmodels/SW_ALPS_402097/EC11-THT-25K-green.step
3dmodels/SW_ALPS_402097/EC11-THT-25F-blue.step
3dmodels/SW_ALPS_402097/EC11-THT-15R-thread-green.step
3dmodels/SW_ALPS_402097/EC11-THT-25F-black.step
3dmodels/SW_ALPS_402097/EC11-THT-25R-black.step
3dmodels/SW_ALPS_402097/EC11-THT-20K-thread-green.step
3dmodels/SW_ALPS_402097/EC11-THT-15R-blue.step
3dmodels/SW_ALPS_402097/EC11-THT-20K-thread-black.step
3dmodels/SW_ALPS_402097/EC11-THT-20F-thread-blue.step
3dmodels/SW_ALPS_402097/EC11-THT-20F-thread-green.step
3dmodels/SW_ALPS_402097/EC11-THT-15R-green.step
3dmodels/SW_ALPS_402097/EC11-THT-20F-green.step
3dmodels/SW_ALPS_402097/EC11-THT-20R-thread-blue.step
3dmodels/SW_ALPS_402097/EC11-THT-25F-thread-green.step
3dmodels/SW_ALPS_402097/EC11-THT-20F-blue.step
3dmodels/SW_ALPS_402097/EC11-THT-15R-thread-black.step
3dmodels/SW_ALPS_402097/EC11-THT-15R-thread-blue.step
3dmodels/SW_ALPS_402097/EC11-THT-20R-black.step
3dmodels/SW_ALPS_402097/EC11-THT-25R-thread-green.step
3dmodels/SW_ALPS_402097/EC11-THT-25F-green.step
3dmodels/SW_ALPS_402097/EC11-THT-25R-thread-blue.step
3dmodels/SW_ALPS_402097/EC11-THT-25K-thread-black.step
3dmodels/BKL_072759/072760-3d.step
3dmodels/EXCEL_ESP4020/JS102011SAQN--3DModel-Eagle-1.STEP
3dmodels/FREESC_MPX2200/User Library-MPX5100GP-2.SLDPRT
3dmodels/I2C-OLED-Display_128x32/128x32-OLED.SLDPRT
3dmodels/METZ_AST0210304/st02103hdnn.stp
3dmodels/MOLEX_39303035/039303035.stp
3dmodels/MOLEX_39303045/039303045.stp
3dmodels/MOLEX_436500200/436500200.stp
3dmodels/MOLEX_436500215/436500215.stp
3dmodels/MOLEX_436500300/436500300.stp
3dmodels/MOLEX_436500500/436500500.stp
3dmodels/RTC_DS3231/HW-84 v7.obj
3dmodels/RTC_DS3231/HW-84 v7.stl
3dmodels/TE_RT114730/RT114730.stp
