n0ki20/kicad_share/(commit log)

2024-12-22 added footprints
2024-12-22 added remaining base structure directories
    [0,96-Zoll_OLED_IIC.stp, 039303035.stp, 039303045.stp, 072760-3d.step, 1 EC11-THT-15F-black.stp, 1022.step, 12-23C_R6GHBHC-A01_2C.stp, 128x32-OLED.SLDPRT]
2024-12-29 - added generic resistors - increased size of + and - in LM358 Symbol after setting KiCad Font to Arial
2024-12-30 added power symbols
2024-12-30 New components (Designation; Manufacturer ; ManufacturerID ; Project):
    - 3V3/5V/Adj Boost Converter; Maxim Integrated; MAX1797EUA+; Datalogger_PicoStack
    - 22 uH Inductor; Fastron; 1008F-220K-08; Datalogger_PicoStack
2025-01-17 New components (Designation; Manufacturer ; ManufacturerID ; Project):
    - SMD LED red/green; WE; 150066SV74000; Datalogger
    [WE_150066SV74000.stp]
2025-03-05 New components (Designation; Manufacturer ; ManufacturerID ; Project):
    - 230V Relay; TE Connectivity; RT114730; Transit Motorvorheizung
2025-04-23 New components (Designation; Manufacturer ; ManufacturerID ; Project):
    - KEY_1023; Keystone Electronics; 1023; Solarakku-Anzeige
    [1023.step, RT114730.stp]
2025-08-17 New components (Designation; Manufacturer ; ManufacturerID ; Project):
    - ESP32WROOM32EN4
    [ESP32-WROOM-32E-N4.stp]
2025-08-17 KiCad Settings
2025-09-03 deleted footprint
2025-10-26 neue Datei: 3dmodels/X/PinHeader_1x15_2.54_90_THT.step neue Datei: 3dmodels/X/PinSocket_1x15_2.54_90_THT.step neue Datei: footprints/X_pcbLib_KiCad_noller.pretty/PinHeader_1x15_2.54_90_THT.kicad_mod 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
    [PinHeader_1x15_2.54_90_THT.step, PinSocket_1x15_2.54_90_THT.step]
