n0ki20/kicad_share/(notices)

Notices in the files:
3dmodels/D_SMA.step:
Copyright (C) 2017, kicad StepUp
This program is free software: you can redistribute it and/or modify
it under the terms of the GNU General Public License as published by
the Free Software Foundation, either version 3 of the License, or
any later version.
itself might be covered by the GNU General Public License.
3dmodels/X/PinHeader_1x15_2.54_90_THT.step:
This work is licensed under the [Creative Commons CC-BY-SA 4.0 License](https://creativecommons.org/licenses/by-sa/4.0/legalcode),
with the following exception:
To the extent that the creation of electronic designs that use 'Licensed Material' can be considered to be 'Adapted Material',
You are free to use the library data in your own projects without the obligation to share your project files under this or any other license agreement.
3dmodels/WAGO_2059-303998-403/WAGO_2059-303998-403.stp:
author */ ('License CC BY-ND 4.0'),
